hoglet67/Music5000/doc/WAVE00.gif

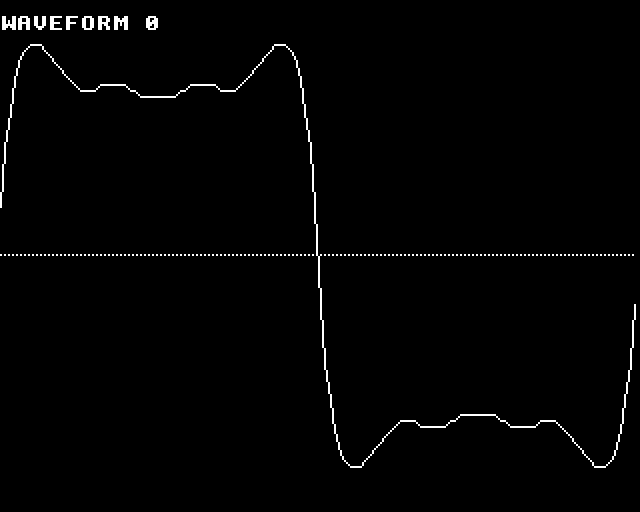
doc/WAVE00.gif
