hoglet67/Music5000/doc/WAVE01.gif

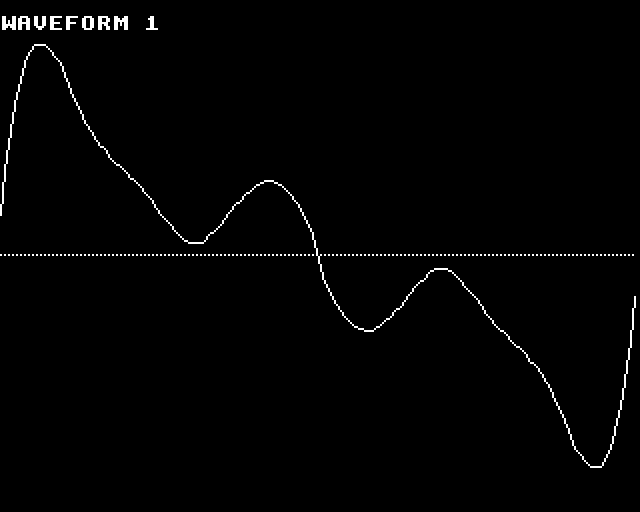
doc/WAVE01.gif
