hoglet67/Music5000/doc/WAVE02.gif

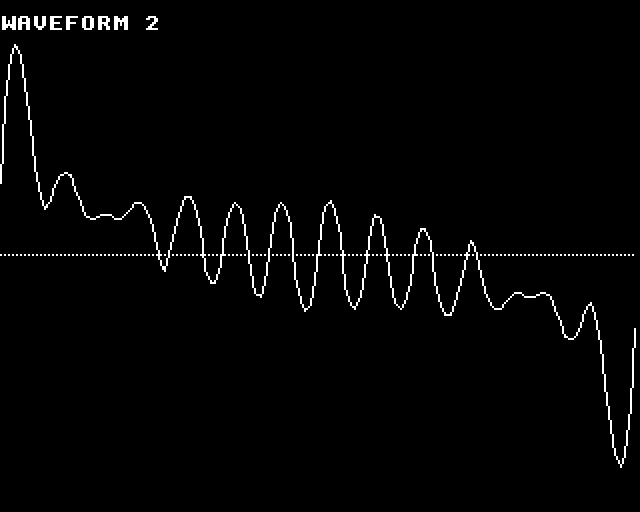
doc/WAVE02.gif
