hoglet67/Music5000/doc/WAVE03.gif

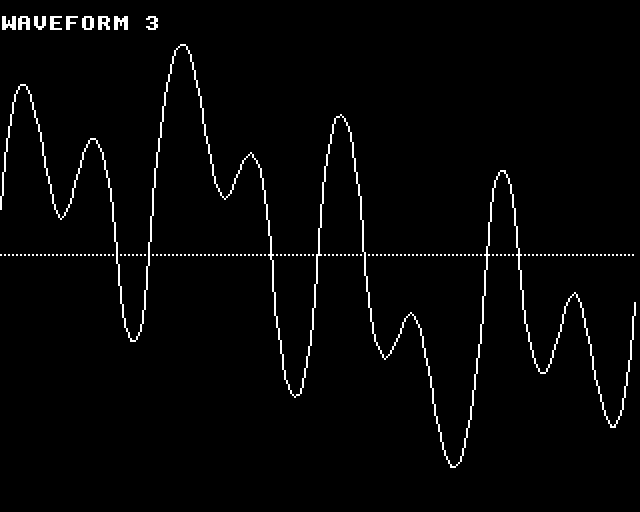
doc/WAVE03.gif
