hoglet67/Music5000/doc/WAVE04.gif

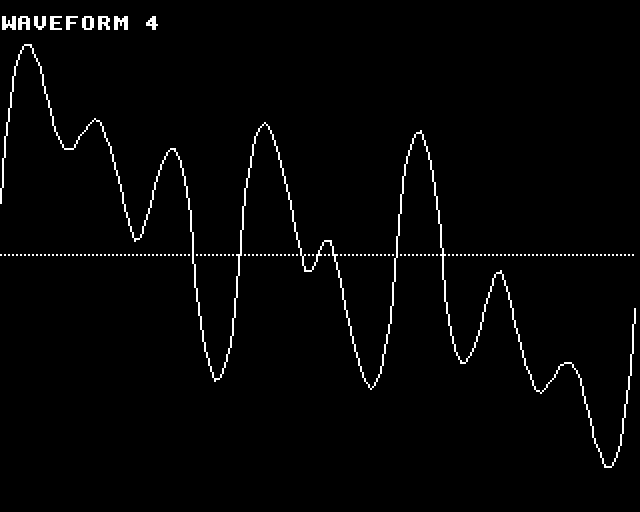
doc/WAVE04.gif
