hoglet67/Music5000/doc/WAVE05.gif

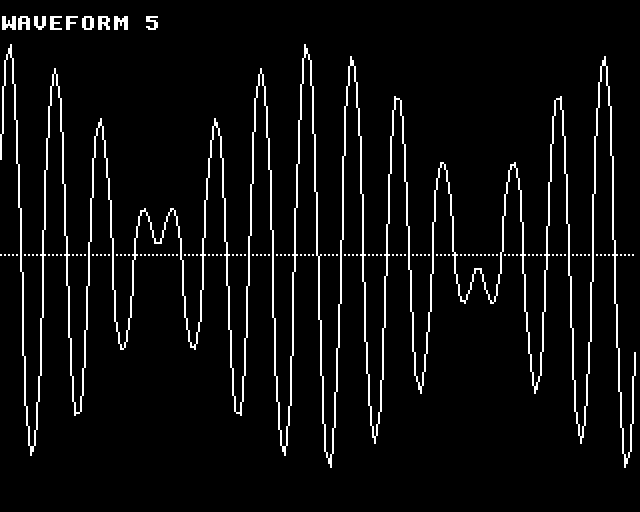
doc/WAVE05.gif
