hoglet67/Music5000/doc/WAVE06.gif

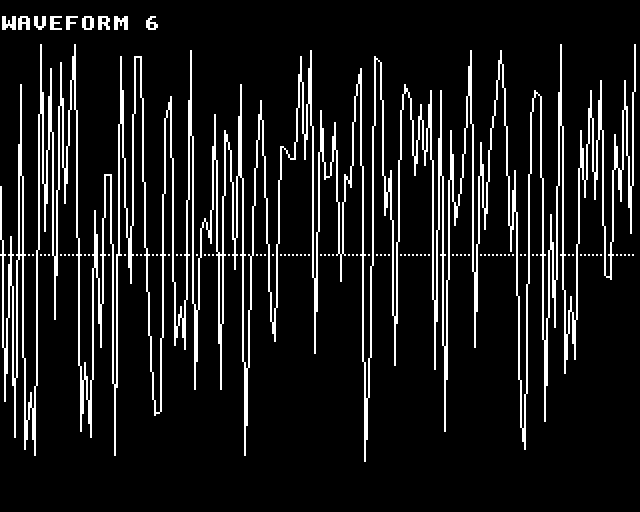
doc/WAVE06.gif
