hoglet67/Music5000/doc/WAVE07.gif

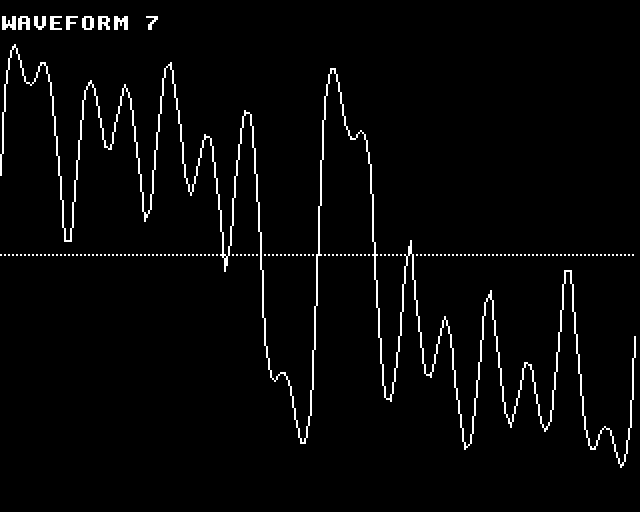
doc/WAVE07.gif
