hoglet67/Music5000/doc/WAVE08.gif

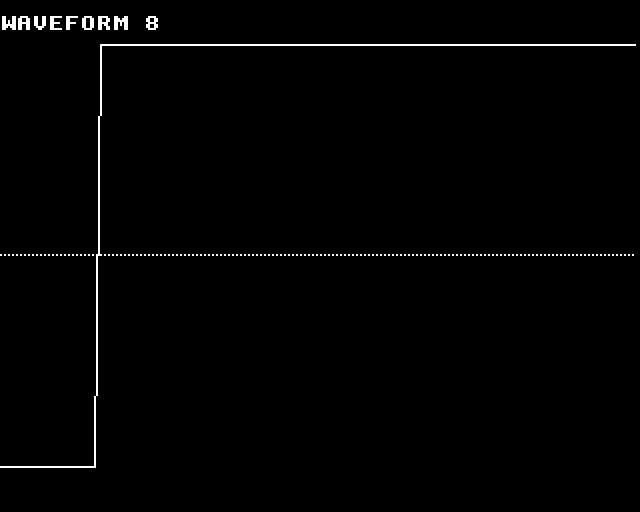
doc/WAVE08.gif
