hoglet67/Music5000/doc/WAVE09.gif

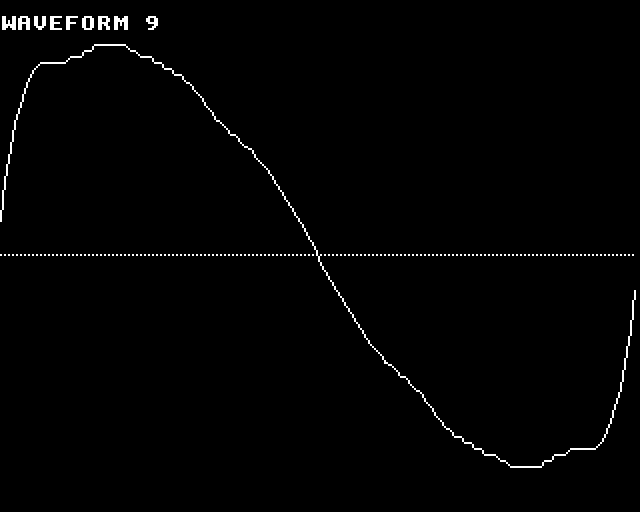
doc/WAVE09.gif
