hoglet67/Music5000/doc/WAVE10.gif

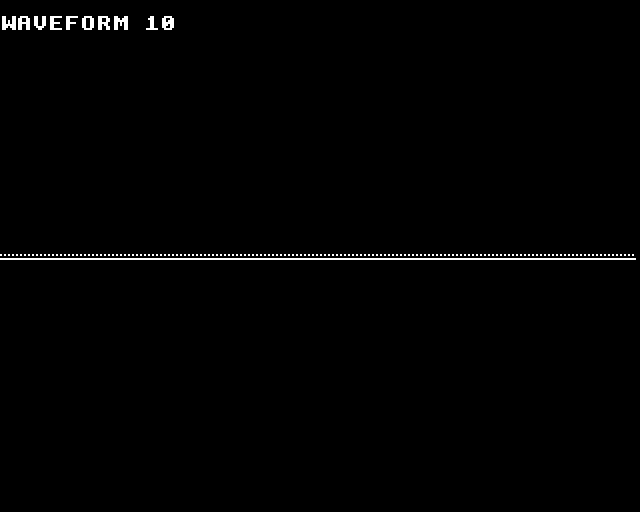
doc/WAVE10.gif
