hoglet67/Music5000/doc/WAVE11.gif

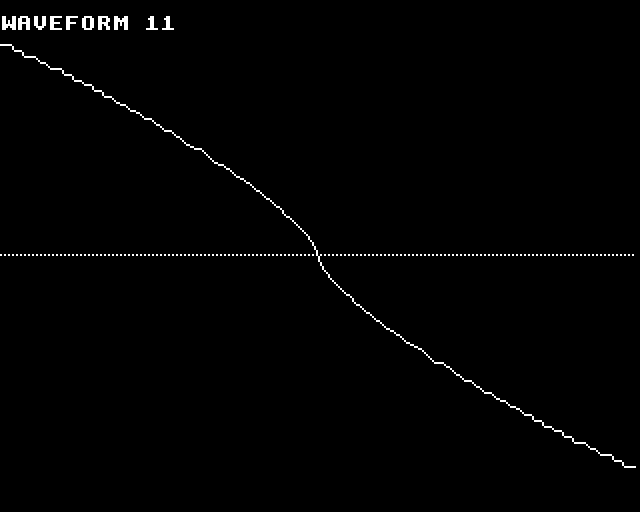
doc/WAVE11.gif
