hoglet67/Music5000/doc/WAVE12.gif

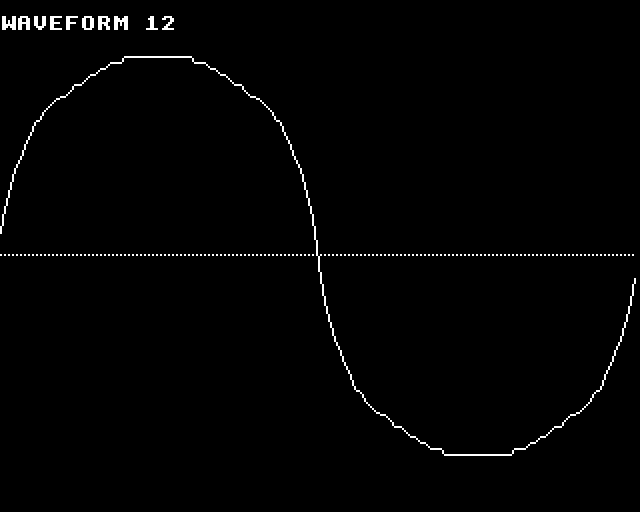
doc/WAVE12.gif
