hoglet67/Music5000/doc/WAVE13.gif

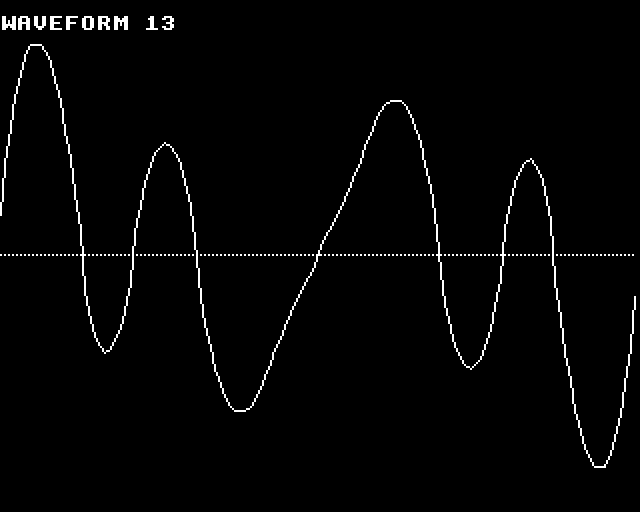
doc/WAVE13.gif
