hoglet67/Music5000/kicad/v1/Music5000.kicad_pcb

## KiCad design kicad/v1/Music5000.kicad_pcb (2019-03-05, last stored version)

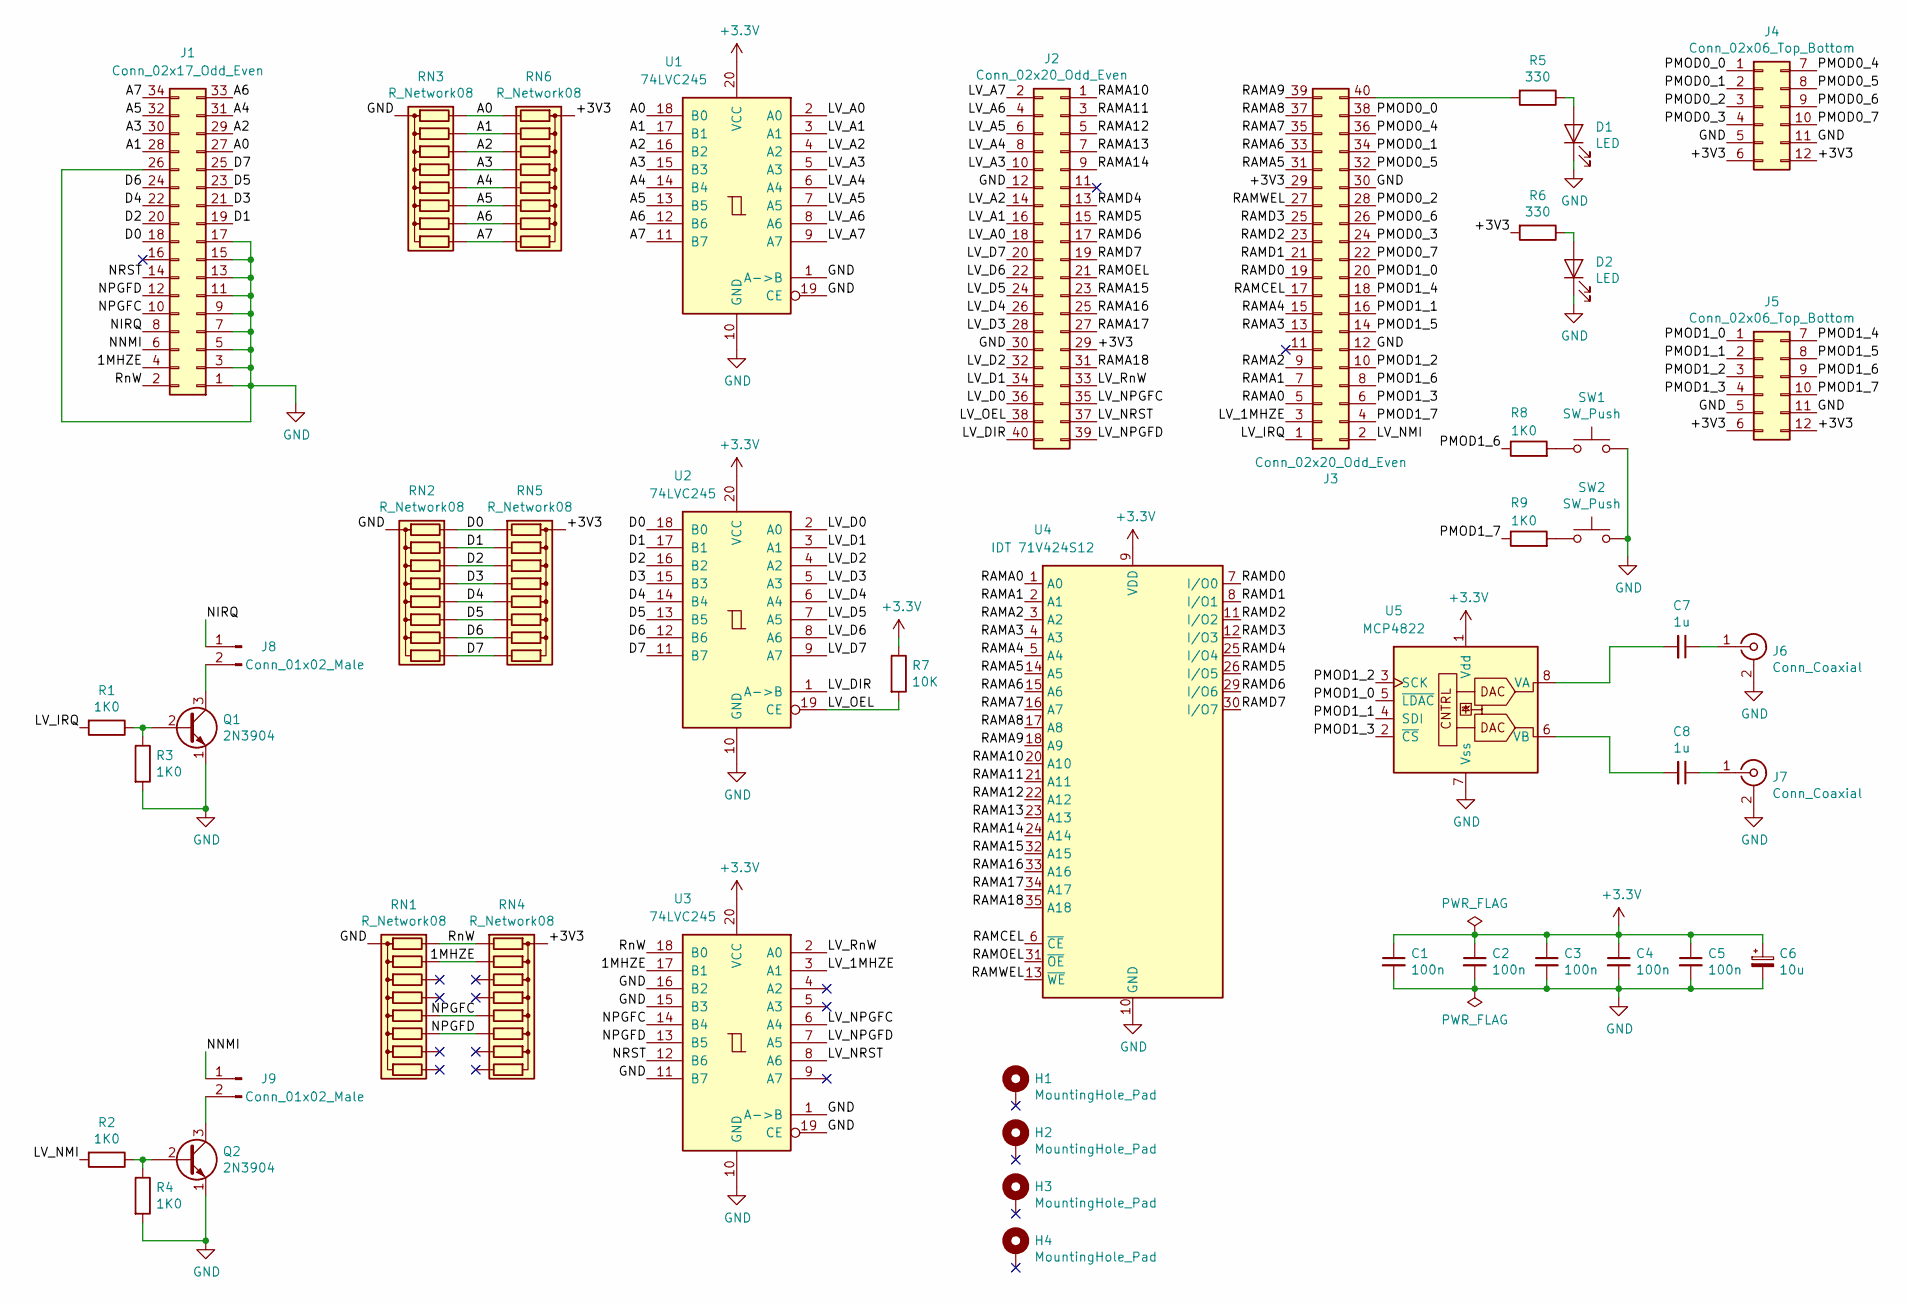
[picture p15: schematic Music5000.sch]

Parts:
C1, C2, C3, C4, C5: 100n; C_Axial_L5.1mm_D3.1mm_P10.00mm_Horizontal
C6: 10u; CP_Radial_D5.0mm_P2.50mm
C7, C8: 1u; C_Rect_L7.2mm_W5.5mm_P5.00mm_FKS2_FKP2_MKS2_MKP2
D1, D2: LED; LED_D3.0mm
H1, H2, H3, H4: MountingHole_Pad; MountingHole_3.2mm_M3_Pad
J1: Conn_02x17_Odd_Even; IDC-Header_2x17_P2.54mm_Horizontal_Lock
J2, J3: Conn_02x20_Odd_Even; PinSocket_2x20_P2.54mm_Vertical
J4, J5: Conn_02x06_Top_Bottom; PinSocket_2x06_P2.54mm_Horizontal
J6, J7: Conn_Coaxial; phono
J8, J9: Conn_01x02_Male; PinHeader_1x02_P2.54mm_Vertical
Q1, Q2: 2N3904; TO-92_HandSolder
R1, R2, R3, R4, R8, R9: 1K0; R_Axial_DIN0207_L6.3mm_D2.5mm_P10.16mm_Horizontal
R5, R6: 330; R_Axial_DIN0207_L6.3mm_D2.5mm_P10.16mm_Horizontal
R7: 10K; R_Axial_DIN0207_L6.3mm_D2.5mm_P10.16mm_Horizontal
RN1, RN2, RN3, RN4, RN5, RN6: R_Network08; R_Array_SIP9
SW1, SW2: SW_Push; SW_PUSH_6mm_H5mm
U1, U2, U3: 74LVC245; DIP-20_W7.62mm_Socket
U4: IDT 71V424S12; SOJ-36_10.16x23.49mm_P1.27mm
U5: MCP4822; DIP-8_W7.62mm_Socket

Connections:
/1MHZE: J1.4, RN1.3 (R2), RN4.3 (R2), U3.17 (B1)
/A0: J1.27, RN3.2 (R1), RN6.2 (R1), U1.18 (B0)
/A1: J1.28, RN3.3 (R2), RN6.3 (R2), U1.17 (B1)
/A2: J1.29, RN3.4 (R3), RN6.4 (R3), U1.16 (B2)
/A3: J1.30, RN3.5 (R4), RN6.5 (R4), U1.15 (B3)
/A4: J1.31, RN3.6 (R5), RN6.6 (R5), U1.14 (B4)
/A5: J1.32, RN3.7 (R6), RN6.7 (R6), U1.13 (B5)
/A6: J1.33, RN3.8 (R7), RN6.8 (R7), U1.12 (B6)
/A7: J1.34, RN3.9 (R8), RN6.9 (R8), U1.11 (B7)
/D0: J1.18, RN2.2 (R1), RN5.2 (R1), U2.18 (B0)
/D1: J1.19, RN2.3 (R2), RN5.3 (R2), U2.17 (B1)
/D2: J1.20, RN2.4 (R3), RN5.4 (R3), U2.16 (B2)
/D3: J1.21, RN2.5 (R4), RN5.5 (R4), U2.15 (B3)
/D4: J1.22, RN2.6 (R5), RN5.6 (R5), U2.14 (B4)
/D5: J1.23, RN2.7 (R6), RN5.7 (R6), U2.13 (B5)
/D6: J1.24, RN2.8 (R7), RN5.8 (R7), U2.12 (B6)
/D7: J1.25, RN2.9 (R8), RN5.9 (R8), U2.11 (B7)
/LV_1MHZE: J3.3, U3.3 (A1)
/LV_A0: J2.18, U1.2 (A0)
/LV_A1: J2.16, U1.3 (A1)
/LV_A2: J2.14, U1.4 (A2)
/LV_A3: J2.10, U1.5 (A3)
/LV_A4: J2.8, U1.6 (A4)
/LV_A5: J2.6, U1.7 (A5)
/LV_A6: J2.4, U1.8 (A6)
/LV_A7: J2.2, U1.9 (A7)
/LV_D0: J2.36, U2.2 (A0)
/LV_D1: J2.34, U2.3 (A1)
/LV_D2: J2.32, U2.4 (A2)
/LV_D3: J2.28, U2.5 (A3)
/LV_D4: J2.26, U2.6 (A4)
/LV_D5: J2.24, U2.7 (A5)
/LV_D6: J2.22, U2.8 (A6)
/LV_D7: J2.20, U2.9 (A7)
/LV_DIR: J2.40, U2.1 (A->B)
/LV_IRQ: J3.1, R1.2
/LV_NMI: J3.2, R2.2
/LV_NPGFC: J2.35, U3.6 (A4)
/LV_NPGFD: J2.39, U3.7 (A5)
/LV_NRST: J2.37, U3.8 (A6)
/LV_OEL: J2.38, R7.2, U2.19 (CE)
/LV_RnW: J2.33, U3.2 (A0)
/NIRQ: J1.8, J8.1
/NNMI: J1.6, J9.1
/NPGFC: J1.10, RN1.6 (R5), RN4.6 (R5), U3.14 (B4)
/NPGFD: J1.12, RN1.7 (R6), RN4.7 (R6), U3.13 (B5)
/NRST: J1.14, U3.12 (B6)
/PMOD0_0: J3.38, J4.1
/PMOD0_1: J3.34, J4.2
/PMOD0_2: J3.28, J4.3
/PMOD0_3: J3.24, J4.4
/PMOD0_4: J3.36, J4.7
/PMOD0_5: J3.32, J4.8
/PMOD0_6: J3.26, J4.9
/PMOD0_7: J3.22, J4.10
/PMOD1_0: J3.20, J5.1, U5.5 (~LDAC)
/PMOD1_1: J3.16, J5.2, U5.4 (SDI)
/PMOD1_2: J3.10, J5.3, U5.3 (SCK)
/PMOD1_3: J3.6, J5.4, U5.2 (~CS)
/PMOD1_4: J3.18, J5.7
/PMOD1_5: J3.14, J5.8
/PMOD1_6: J3.8, J5.9, R8.1
/PMOD1_7: J3.4, J5.10, R9.1
/RAMA0: J3.5, U4.1 (A0)
/RAMA1: J3.7, U4.2 (A1)
/RAMA2: J3.9, U4.3 (A2)
/RAMA3: J3.13, U4.4 (A3)
/RAMA4: J3.15, U4.5 (A4)
/RAMA5: J3.31, U4.14 (A5)
/RAMA6: J3.33, U4.15 (A6)
/RAMA7: J3.35, U4.16 (A7)
/RAMA8: J3.37, U4.17 (A8)
/RAMA9: J3.39, U4.18 (A9)
/RAMA10: J2.1, U4.20 (A10)
/RAMA11: J2.3, U4.21 (A11)
/RAMA12: J2.5, U4.22 (A12)
/RAMA13: J2.7, U4.23 (A13)
/RAMA14: J2.9, U4.24 (A14)
/RAMA15: J2.23, U4.32 (A15)
/RAMA16: J2.25, U4.33 (A16)
/RAMA17: J2.27, U4.34 (A17)
/RAMA18: J2.31, U4.35 (A18)
/RAMCEL: J3.17, U4.6 (~CE)
/RAMD0: J3.19, U4.7 (I/O0)
/RAMD1: J3.21, U4.8 (I/O1)
/RAMD2: J3.23, U4.11 (I/O2)
/RAMD3: J3.25, U4.12 (I/O3)
/RAMD4: J2.13, U4.25 (I/O4)
/RAMD5: J2.15, U4.26 (I/O5)
/RAMD6: J2.17, U4.29 (I/O6)
/RAMD7: J2.19, U4.30 (I/O7)
/RAMOEL: J2.21, U4.31 (~OE)
/RAMWEL: J3.27, U4.13 (~WE)
/RnW: J1.2, RN1.2 (R1), RN4.2 (R1), U3.18 (B0)
GND: C1.2, C2.2, C3.2, C4.2, C5.2, C6.2, D1.1 (K), D2.1 (K), J1.1, J1.3, J1.5, J1.7, J1.9, J1.11, J1.13, J1.15, J1.17, J1.26, J2.12, J2.30, J3.12, J3.30, J4.5, J4.11, J5.5, J5.11, J6.2 (Ext), J7.2 (Ext), Q1.1 (E), Q2.1 (E), R3.2, R4.2, RN1.1 (common), RN2.1 (common), RN3.1 (common), SW1.2, SW2.2, U1.1 (A->B), U1.10 (GND), U1.19 (CE), U2.10 (GND), U3.1 (A->B), U3.10 (GND), U3.11 (B7), U3.15 (B3), U3.16 (B2), U3.19 (CE), U4.10 (GND), U4.28 (GND), U5.7 (Vss)
unnamed: C7.1, J6.1 (In)
unnamed: C7.2, U5.8 (VA)
unnamed: C8.1, J7.1 (In)
unnamed: C8.2, U5.6 (VB)
unnamed: D1.2 (A), R5.1
unnamed: D2.2 (A), R6.1
unnamed: J3.40, R5.2
unnamed: J8.2, Q1.3 (C)
unnamed: J9.2, Q2.3 (C)
unnamed: Q1.2 (B), R1.1, R3.1
unnamed: Q2.2 (B), R2.1, R4.1
unnamed: R8.2, SW1.1
unnamed: R9.2, SW2.1

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
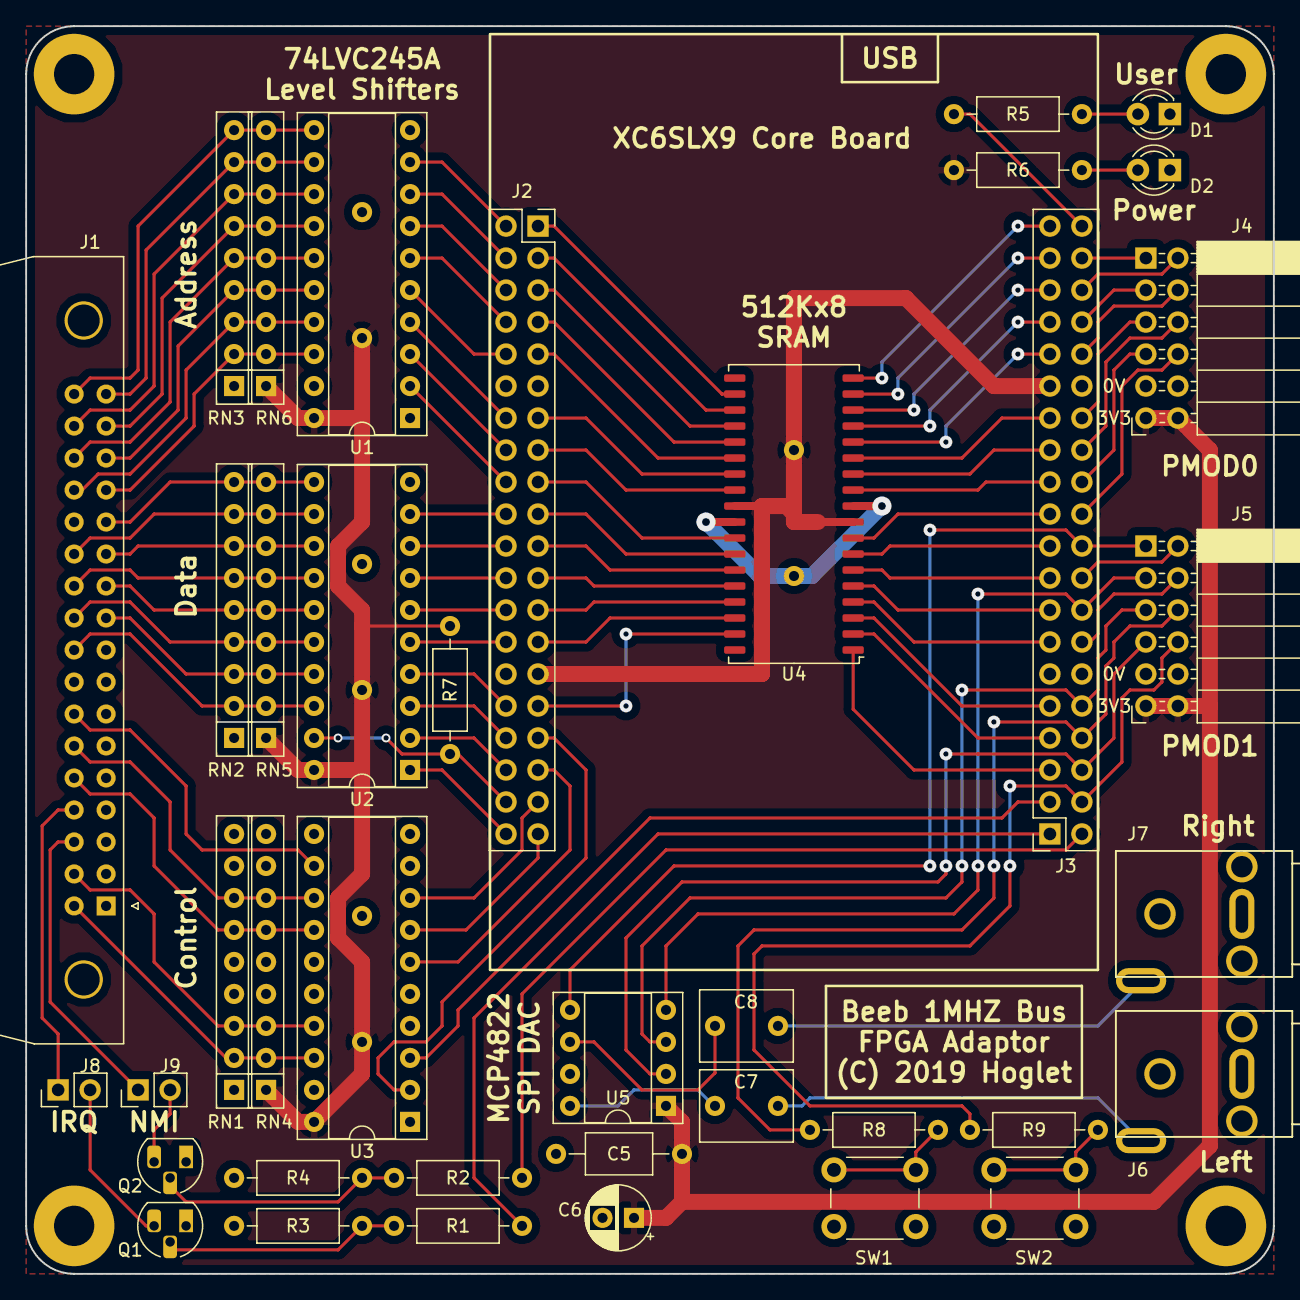
[picture p16: board Music5000.kicad_pcb from above]

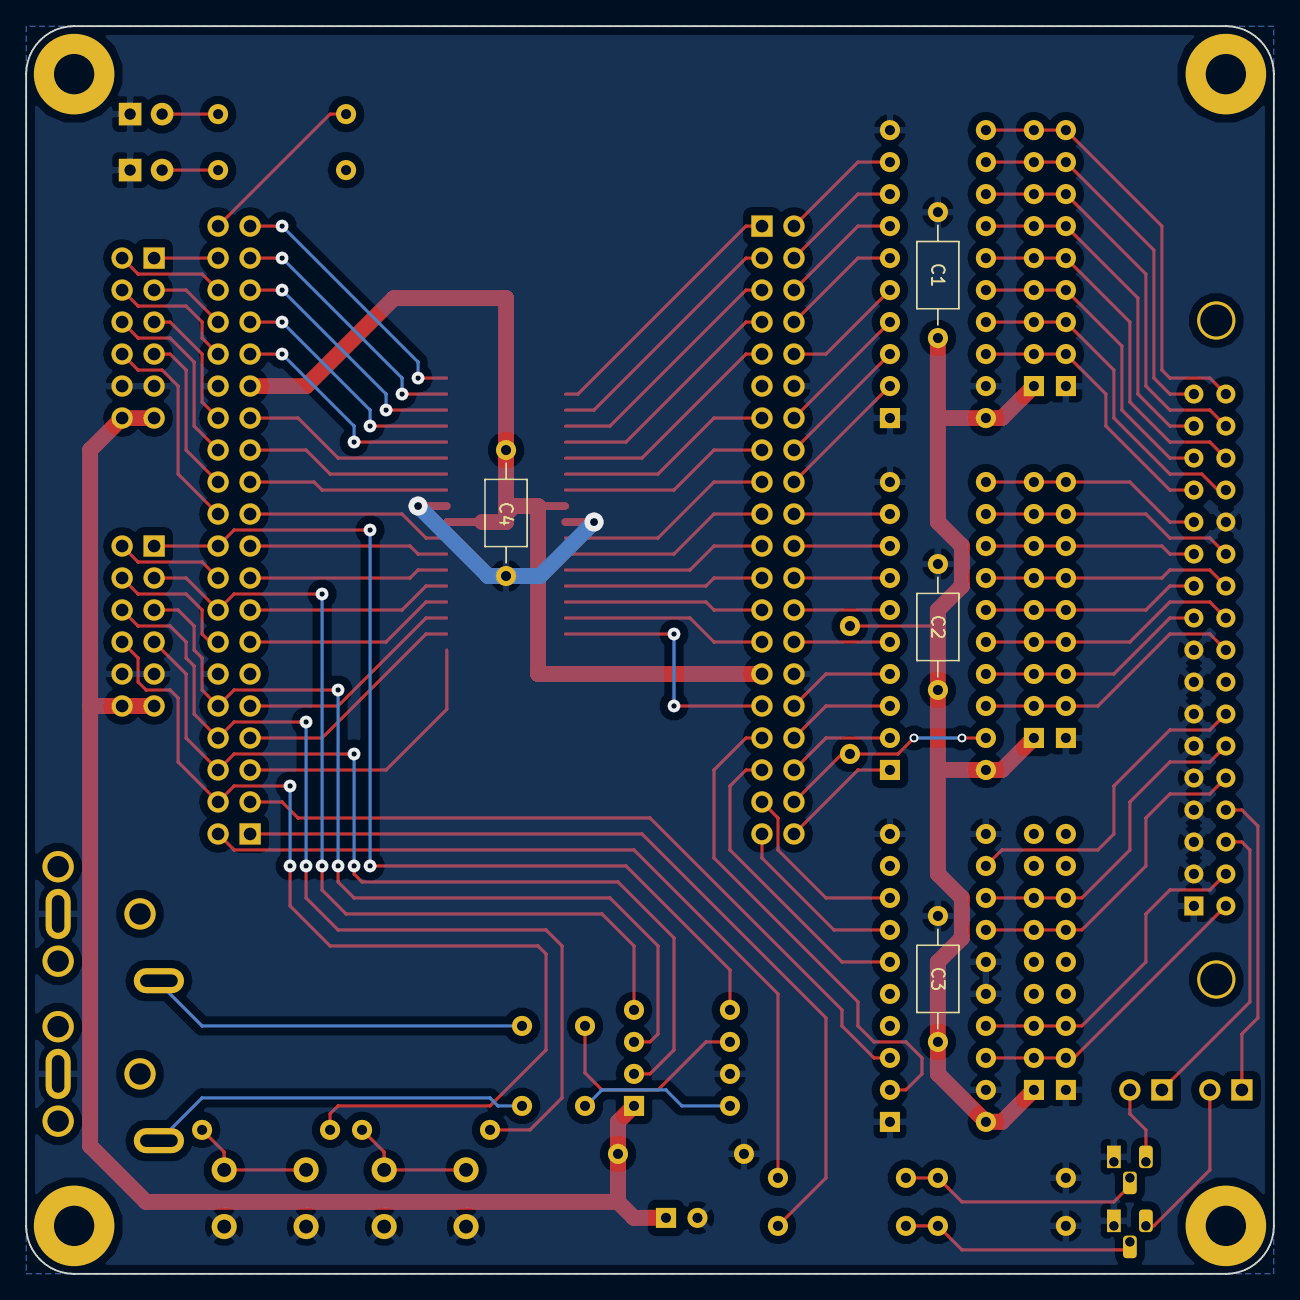
[picture p17: board Music5000.kicad_pcb from below]

Board: 2 copper layers, 99.1 x 99.1 mm, 47 parts (4 on the bottom side), 109 nets.
