hoglet67/Music5000/(commit log)

2014-11-20 Fixed a couple of small bugs, and updated to use an external MCP4822 12-bit DAC
2019-03-01 Added v1 of 1MHz Bus FPGA Adapter PCB
    [Music5000.kicad_pcb, Music5000.sch]
2019-03-02 Added dout_oel; Hardware is deselected on reset
    [Music5000SpiDac.vhd]
2019-03-02 Updated reset behaviour to match real M5K, including writing to wave ram
    [Music5000SpiDac.vhd]
2019-03-02 Music5000_gop: Fixed very incorrect clock frequency
    [Music5000_gop.vhd]
2019-03-05 PCB: Added switches
    [Music5000.kicad_pcb, Music5000.sch]
2019-03-05 PCB: Added manufacturing data
    [Music5000.gbl, Music5000.gbo, Music5000.gbs, Music5000.gko, Music5000.gtl, Music5000.gto, Music5000.gts, Music5000.xln]
2019-03-06 Fixed incorrect case of module name
    [Music5000SpiDac.vhd, Music5000_lx9core.vhd]
2019-03-06 Fixed incorrect clke polarity (both seem to work though)
    [Music5000SpiDac.vhd]
2019-03-07 Bus Adapter PCB now in Beeb1MHzFpga project
    [Music5000.kicad_pcb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]
2019-05-05 Remove RSTn from LED, so only SW1 and SW2 affect it
2019-06-10 Dom JIM API tests and fixes
    Make OWL logo boot user select able at boot (hold SW1)
    FIX: only enable data buffer for reads when necessary - was clobbering all other FRED/JIM devices
    [Music5000SpiDac.vhd, Music5000_lx9core.vhd]
2019-06-10 Use PMOD2(3) to disable owl when jumpered to ground
2023-10-14 Added a 3rd order butterworth output filter (uses a 19x25 multiplier)
2023-10-14 Fixed some bugs in the iir filter (found with simulation)
2023-10-15 refactor iir filter (work in progress)
