hoglet67/Music5000/(notices)

Notices in the files:
kicad/v1/Music5000.kicad_pcb:
(C) 2019 Hoglet
